dwight9339/microbiome/packs/glade/src/scene.png

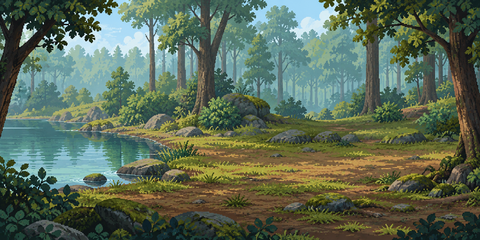
packs/glade/src/scene.png
