dwight9339/microbiome/hardware/enclosure/out/preview_front.png

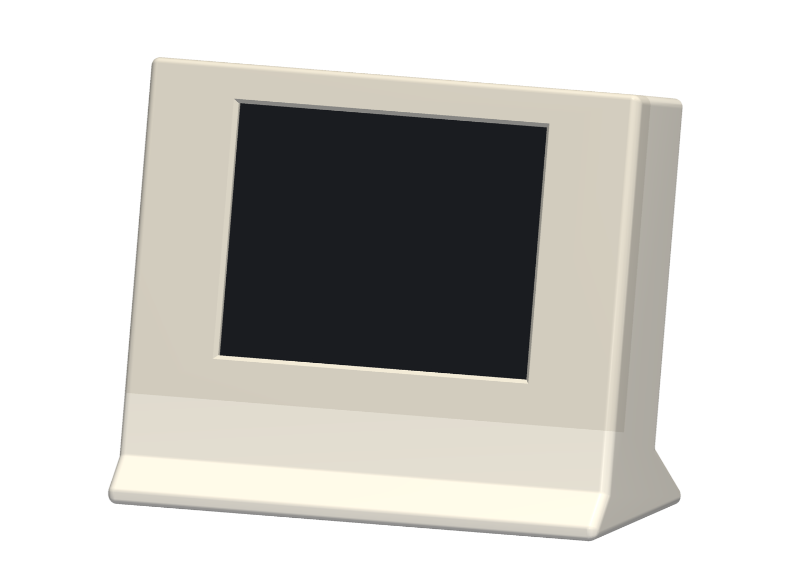
hardware/enclosure/out/preview_front.png
