dwight9339/microbiome/hardware/enclosure/out/preview_rear.png

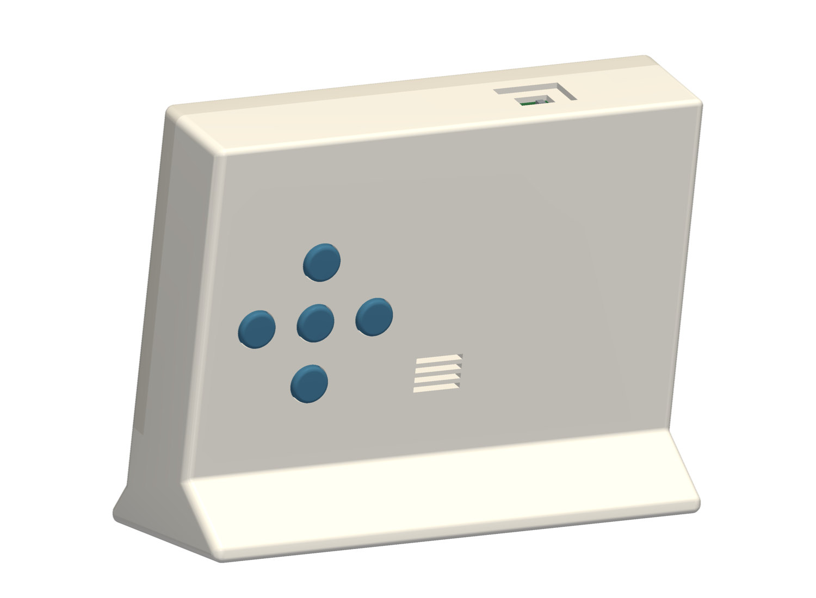
hardware/enclosure/out/preview_rear.png
