dwight9339/microbiome/hardware/enclosure/out/preview_rear_inside.png

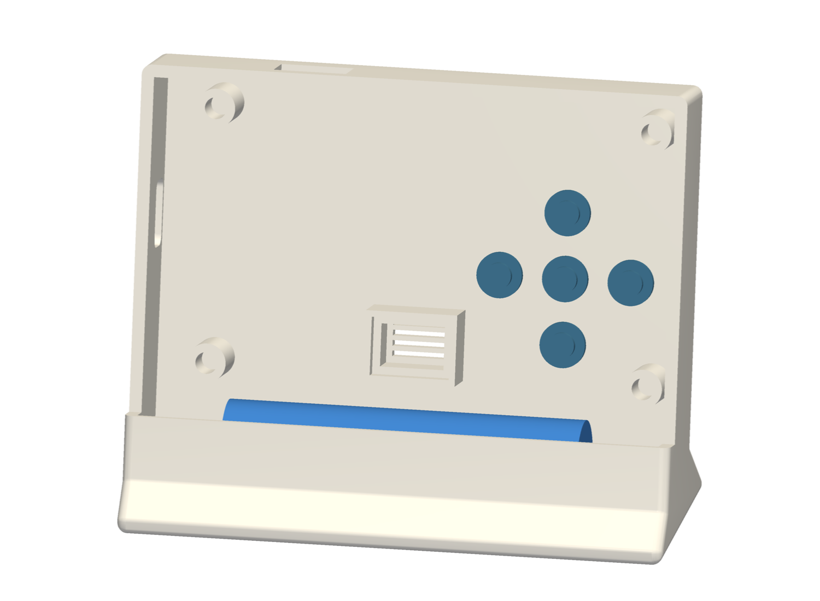
hardware/enclosure/out/preview_rear_inside.png
