dwight9339/microbiome/hardware/enclosure/out/preview_section_buttons.png

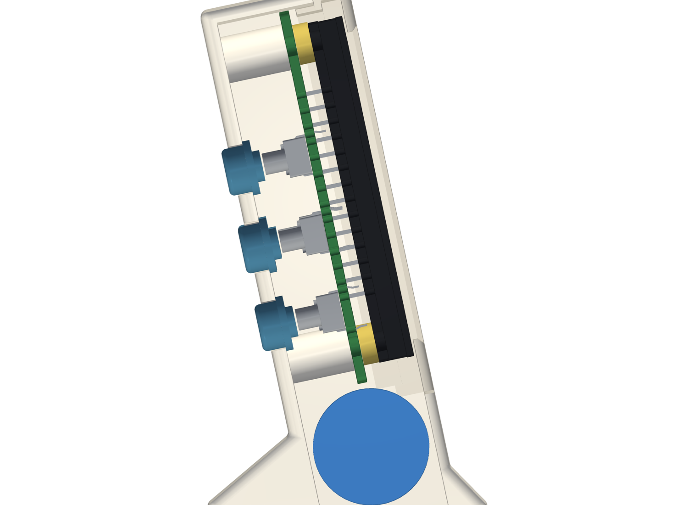
hardware/enclosure/out/preview_section_buttons.png
