dwight9339/microbiome/packs/forest/art/far_trees.png

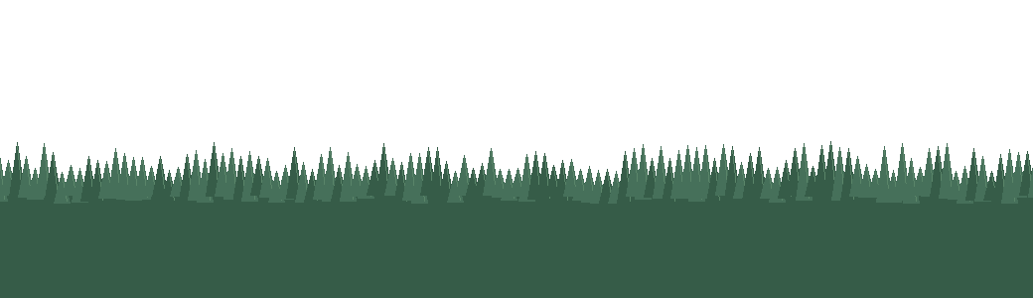
packs/forest/art/far_trees.png
