dwight9339/microbiome/packs/forest/art/foreground.png

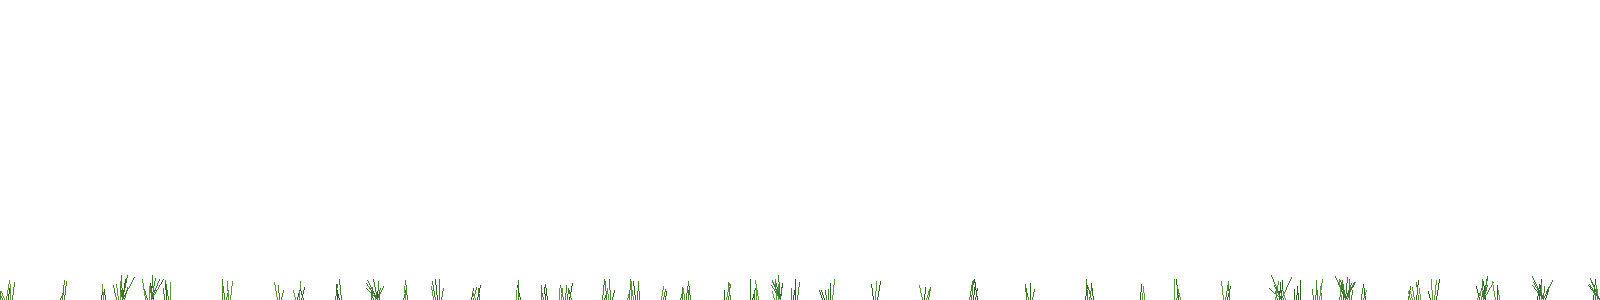
packs/forest/art/foreground.png
