dwight9339/microbiome/packs/forest/art/ground.png

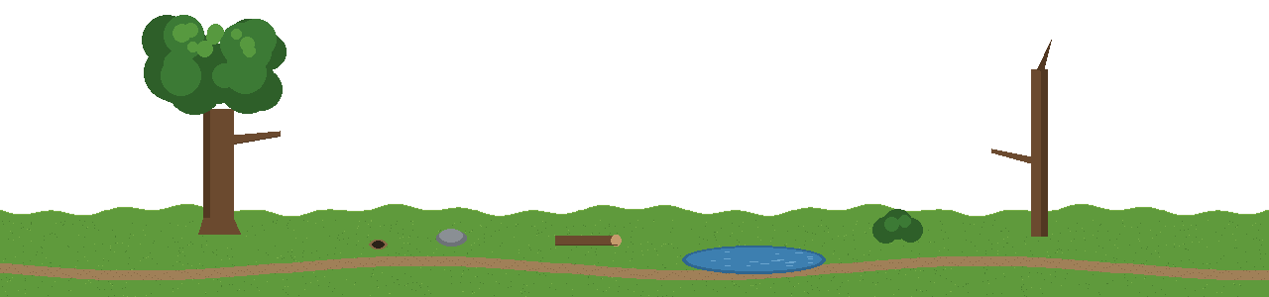
packs/forest/art/ground.png
