dwight9339/microbiome/packs/forest/art/mountains.png

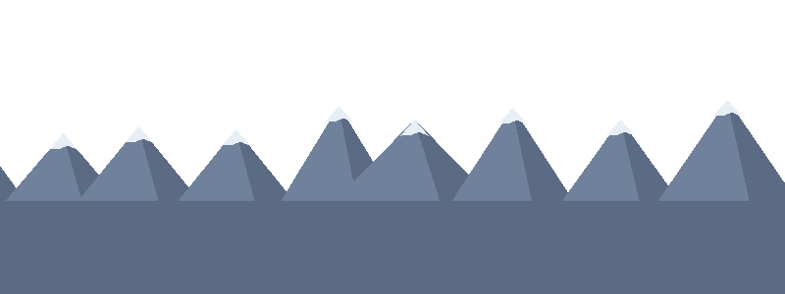
packs/forest/art/mountains.png
