dwight9339/microbiome/packs/glade/art/occlusion.png

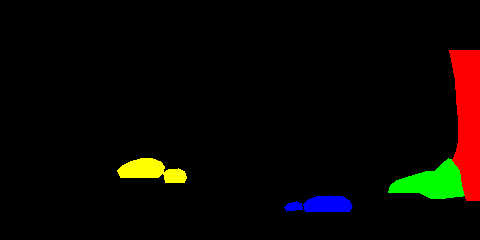
packs/glade/art/occlusion.png
