dwight9339/microbiome/hardware/enclosure/out/microbiome_assembly.FCStd

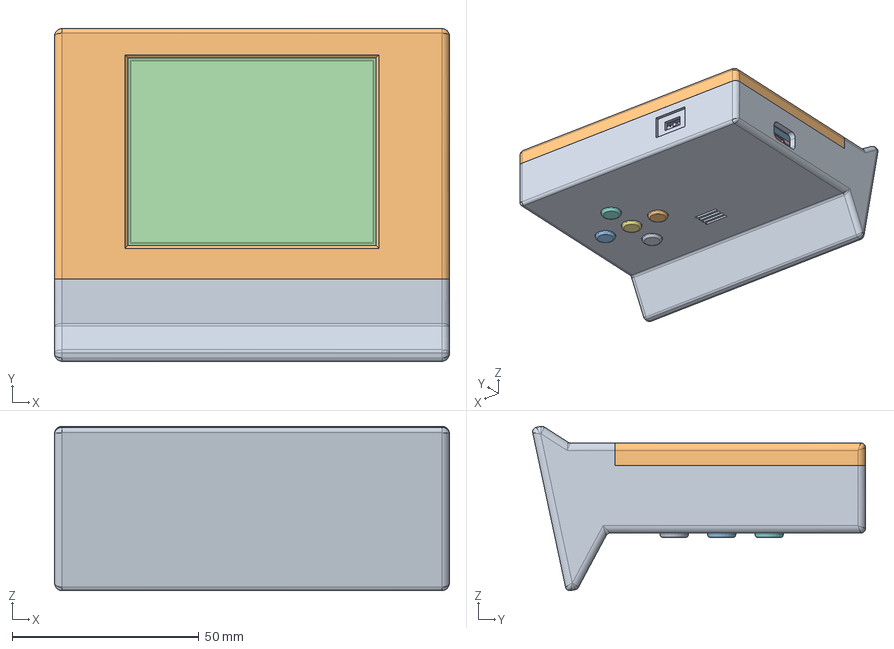
[picture p11: CAD file, 2026-11-13]
hardware/enclosure/out/microbiome_assembly.FCStd
105.7 x 89.1 x 44.0 mm
Rear shell
Front bezel
Carrier PCB
Display module (J2)
Feather RP2350 (J1)
Headers, controls and other components
Button cap - centre
Button cap - up
Button cap - down
Button cap - left
Button cap - right
Display spacer 1
Display spacer 2
Display spacer 3
Display spacer 4
Battery envelope (18.6 x 69 mm)
