dwight9339/microbiome/hardware/prototype_1/prototype_1_pcb.step

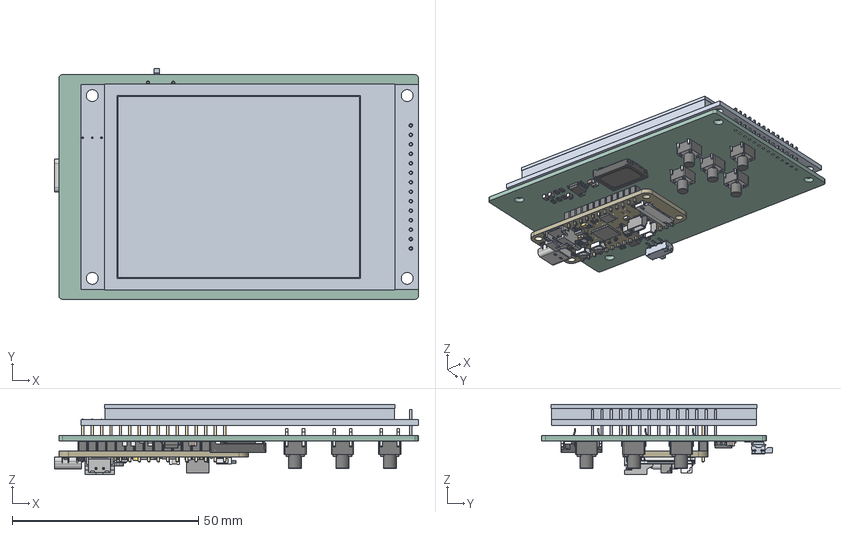
[picture p12: CAD file, 2026-11-13]
hardware/prototype_1/prototype_1_pcb.step
97.7 x 61.9 x 18.9 mm
JS102011SAQN_SW0004_PRT
PinHeader_1x12_P254mm_Vertical
PinHeader_1x16_P254mm_Vertical
Board
0805-NO x 3
CHIPLED_0603_NOOUTLINE x 2
_0402NO x 34
BTN_RKB2_4.6X2.8 x 2
SOT23-5
JSTPH2_BATT
SOT23-5 (1)
0603-NO
SK6805_1515
USON8_4X4
SOD-323F
DFN2015-3
USB_C_CUSB31-CFM2AX-01-X
CRYSTAL_2.5X2
_0603MP x 2
QFN60_7MM_REDUCEDEPAD
INDUCTOR_1007
FPC_22PIN
JST_SH4_RA
JST_SH3_RA
SW_PUSH_6mm_h7.3mm x 5
C_0805_2012Metric x 7
SOIC-8_3.9x4.9mm_P1.27mm x 2
R_0805_2012Metric x 7
AS01508AO-SC-WP-R
prototype_1_PCB
