dwight9339/microbiome/hardware/enclosure/out/rear_shell.step

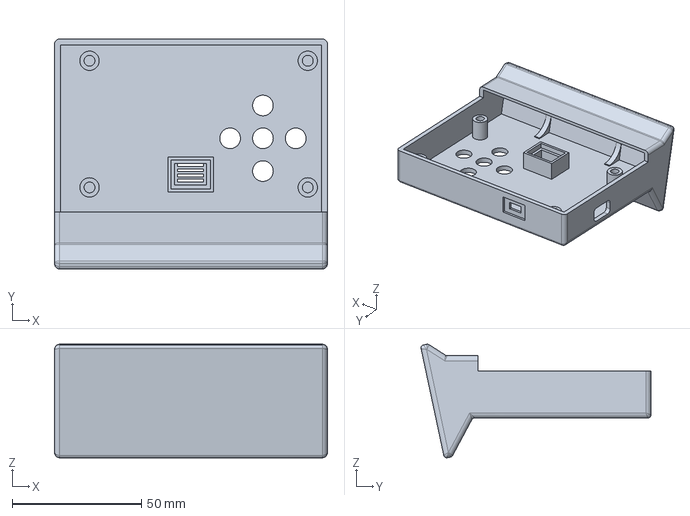
[picture p13: CAD file, 2026-11-13]
hardware/enclosure/out/rear_shell.step
105.7 x 89.1 x 44.0 mm
