dwight9339/microbiome/hardware/prototype_1/3d_models/MSP3223_3p2in_IPS_SPI_DATASHEET_CORRECTED.step

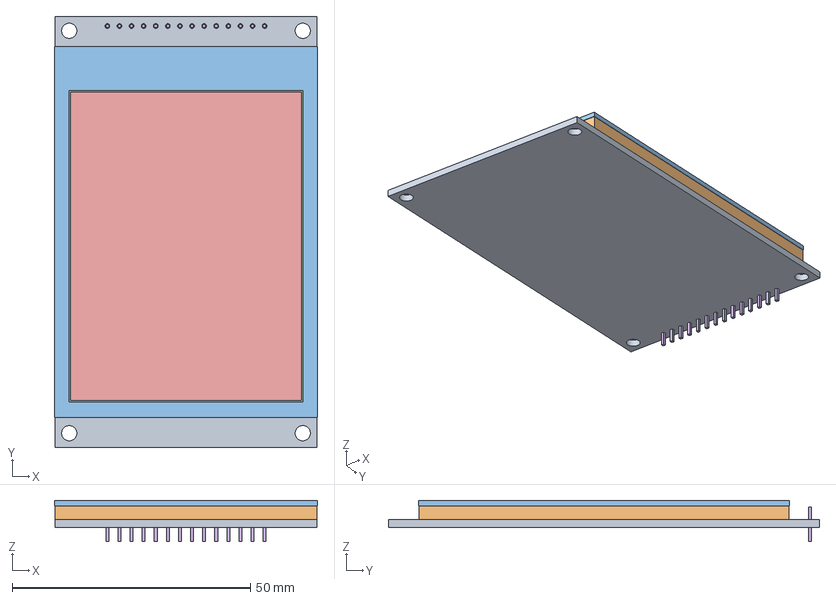
[picture p14: CAD file, 2026-11-13]
hardware/prototype_1/3d_models/MSP3223_3p2in_IPS_SPI_DATASHEET_CORRECTED.step
55.2 x 90.5 x 8.66 mm
