dwight9339/microbiome/hardware/enclosure/out/button_cap.step

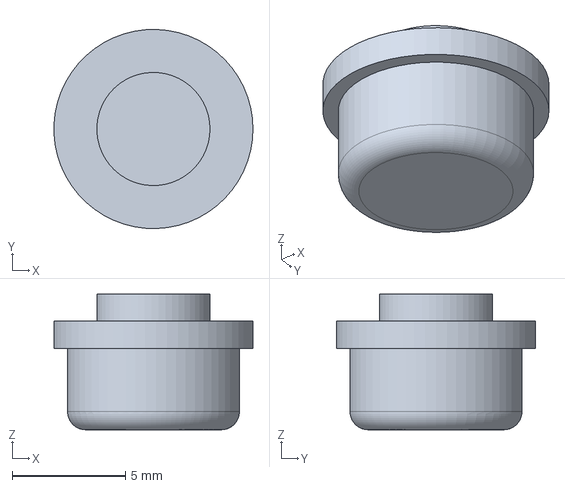
[picture p15: CAD file, 2026-11-13]
hardware/enclosure/out/button_cap.step
8.79 x 8.80 x 5.99 mm
