dwight9339/microbiome/hardware/enclosure/out/display_spacer.step

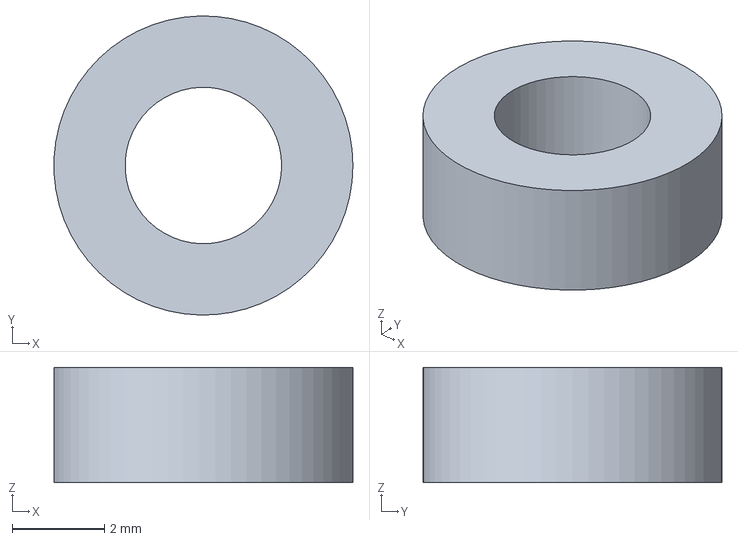
[picture p16: CAD file, 2026-11-13]
hardware/enclosure/out/display_spacer.step
6.50 x 6.50 x 2.50 mm
