dwight9339/microbiome/hardware/enclosure/out/front_bezel.step

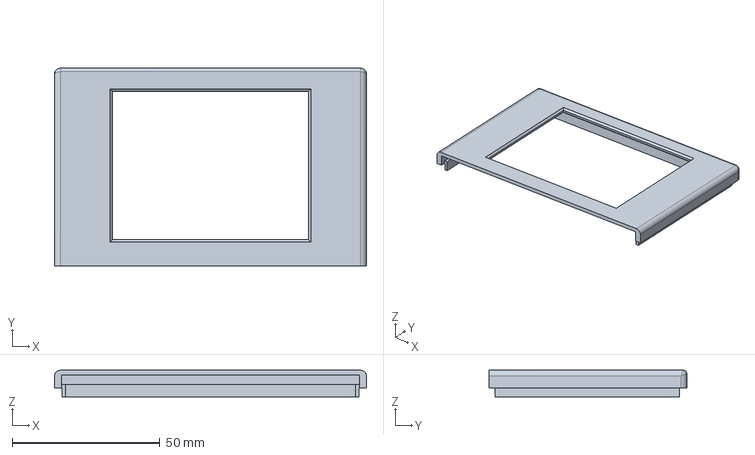
[picture p17: CAD file, 2026-11-13]
hardware/enclosure/out/front_bezel.step
105.7 x 67.0 x 9.00 mm
