dwight9339/microbiome/hardware/prototype_1/3d_models/6000 Feather RP2350.step

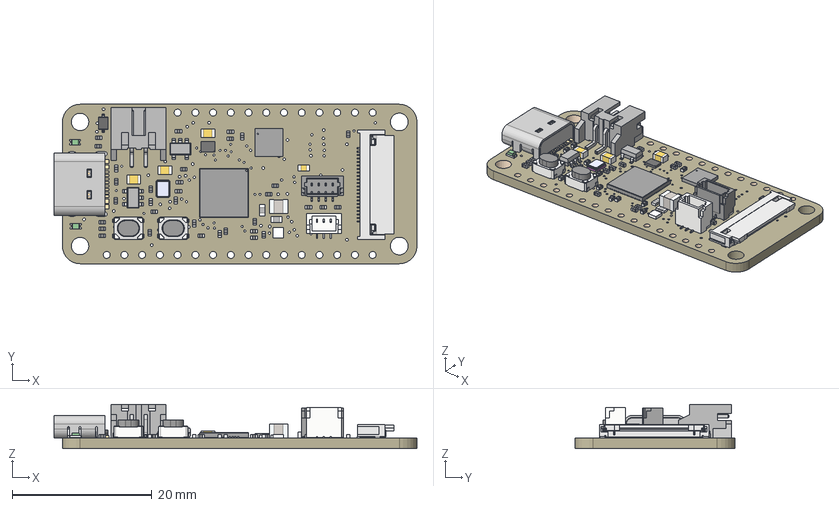
[picture p18: CAD file, 2026-11-13]
hardware/prototype_1/3d_models/6000 Feather RP2350.step
52.0 x 22.9 x 6.37 mm
Board
10uF x 3
ORANGE x 2
10K x 34
KMR2 x 2
RT9080-3.3
JSTPH
MCP73831T-2ACI/OT
10uF_1
WS2812B_SK6805_1515
8MB QSPI
PMEG2020AEA
DMG3415UFY
USB Type C
12MHz/10pF/50ohm
10uF_0603 x 2
DNP
DFE252012F-3R3M=P2
22p TOPCONTACT 0.5mm FPC
STEMMA_I2C_QTRA
JST_SH3
