dwight9339/microbiome/hardware/prototype_1/3d_models/JS102011SAQN.step

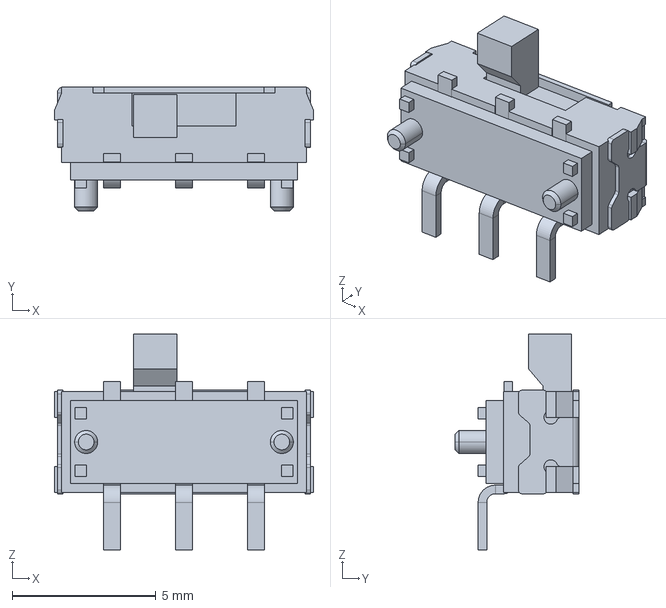
[picture p19: CAD file, 2026-11-13]
hardware/prototype_1/3d_models/JS102011SAQN.step
9.00 x 4.30 x 7.50 mm
