dwight9339/microbiome/hardware/prototype_1/3d_models/AS01508AO-SC-WP-R.STEP

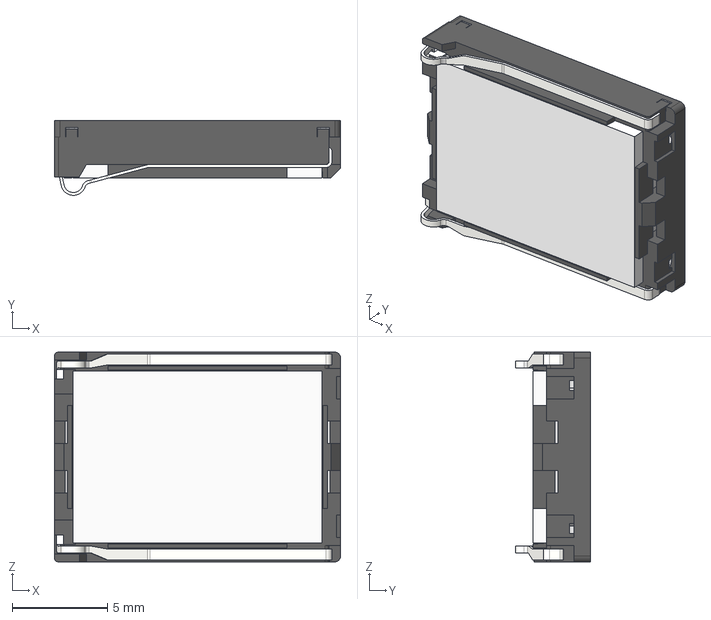
[picture p20: CAD file, 2026-11-13]
hardware/prototype_1/3d_models/AS01508AO-SC-WP-R.STEP
15.0 x 3.92 x 11.0 mm
