dwight9339/microbiome/(list of files, cad)

Other CAD files:
hardware/prototype_1/3d_models/MSP3223_3p2in_IPS_SPI_SIMPLIFIED.step
hardware/enclosure/out/button_cap.stl
hardware/enclosure/out/display_spacer.stl
hardware/enclosure/out/front_bezel.stl
hardware/enclosure/out/rear_shell.stl
