dwight9339/microbiome/hardware/prototype_1/prototype_1.kicad_pcb

## KiCad design hardware/prototype_1/prototype_1.kicad_pcb (2026-11-14)

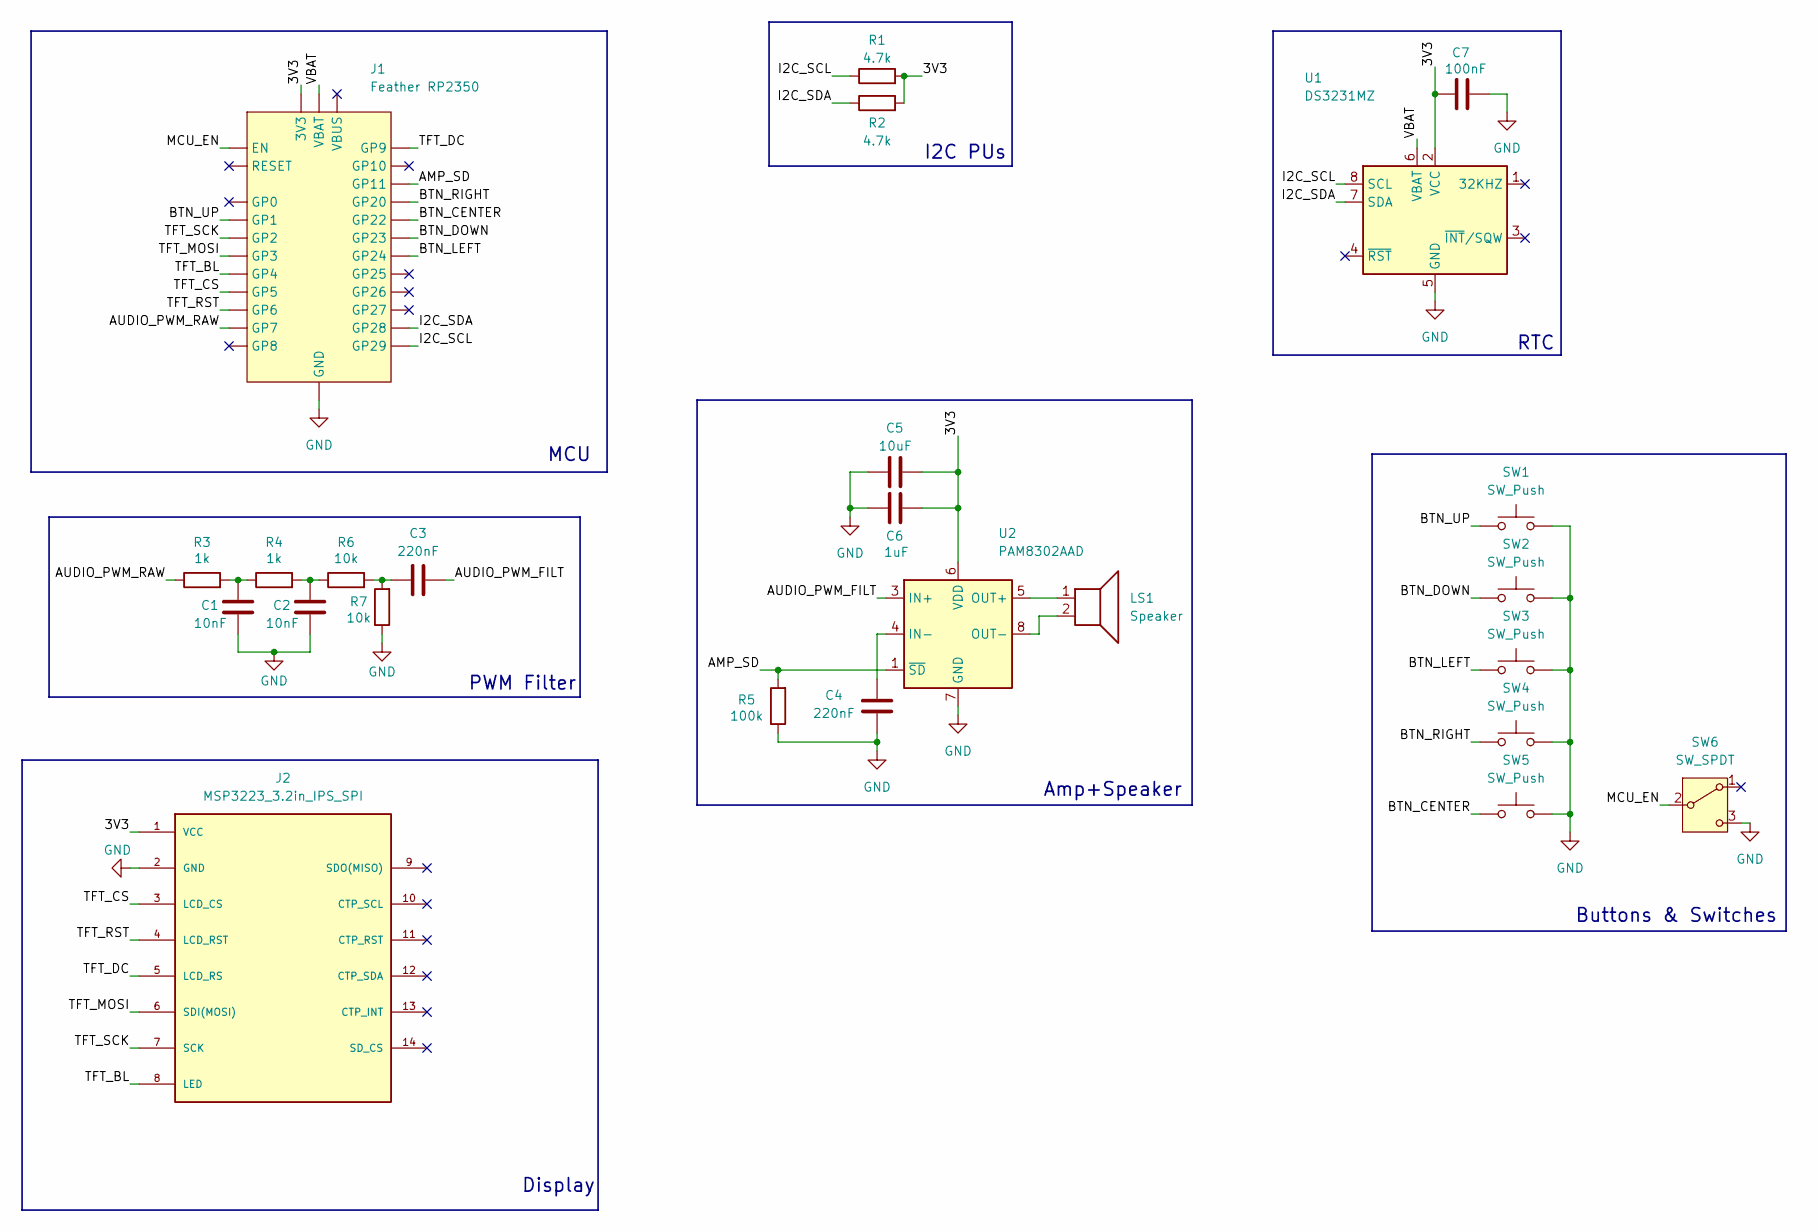
[picture p21: schematic prototype_1.kicad_sch]

Parts:
C1, C2: 10nF; C_0805_2012Metric_Pad1.18x1.45mm_HandSolder
C3, C4: 220nF; C_0805_2012Metric_Pad1.18x1.45mm_HandSolder
C5: 10uF; C_0805_2012Metric_Pad1.18x1.45mm_HandSolder
C6: 1uF; C_0805_2012Metric_Pad1.18x1.45mm_HandSolder
C7: 100nF; C_0805_2012Metric_Pad1.18x1.45mm_HandSolder
J1: Feather RP2350; Adafruit_Feather_RP2350; digikey_part_number 1528-6130-ND
J2: MSP3223_3.2in_IPS_SPI
LS1: Speaker; SPKR_AS01508AO-SC-WP-R; MPN AS01508AO-SC-WP-R; digikey_part_number 668-1514-ND
R1, R2: 4.7k; R_0805_2012Metric_Pad1.20x1.40mm_HandSolder
R3, R4: 1k; R_0805_2012Metric_Pad1.20x1.40mm_HandSolder
R5: 100k; R_0805_2012Metric_Pad1.20x1.40mm_HandSolder
R6, R7: 10k; R_0805_2012Metric_Pad1.20x1.40mm_HandSolder
SW1, SW2, SW3, SW4, SW5: SW_Push; SW_PUSH_6mm_H7.3mm
SW6: SW_SPDT; SW_SPDT_CK_JS102011SAQN
U1: DS3231MZ; SOIC-8_3.9x4.9mm_P1.27mm
U2: PAM8302AAD; SOIC-8_3.9x4.9mm_P1.27mm

Connections:
/3V3: C5.2, C6.2, C7.2, J1.3V3, J2.1 (VCC), R1.2, R2.2, U1.2 (VCC), U2.6 (VDD)
/AMP_SD: J1.GP11, R5.2, U2.1 (~SD)
/AUDIO_PWM_FILT: C3.2, U2.3 (IN+)
/AUDIO_PWM_RAW: J1.GP7, R3.1
/BTN_CENTER: J1.GP22, SW5.1
/BTN_DOWN: J1.GP23, SW2.1
/BTN_LEFT: J1.GP24, SW3.1
/BTN_RIGHT: J1.GP20, SW4.1
/BTN_UP: J1.GP1, SW1.1
/I2C_SCL: J1.GP29, R1.1, U1.8 (SCL)
/I2C_SDA: J1.GP28, R2.1, U1.7 (SDA)
/MCU_EN: J1.EN, SW6.2 (B)
/TFT_BL: J1.GP4, J2.8 (LED)
/TFT_CS: J1.GP5, J2.3 (LCD_CS)
/TFT_DC: J1.GP9, J2.5 (LCD_RS)
/TFT_MOSI: J1.GP3, J2.6 (SDI(MOSI))
/TFT_RST: J1.GP6, J2.4 (LCD_RST)
/TFT_SCK: J1.GP2, J2.7 (SCK)
/VBAT: J1.VBAT, U1.6 (VBAT)
GND: C1.2, C2.2, C4.1, C5.1, C6.1, C7.1, J1.GND, J2.2 (GND), R5.1, R7.1, SW1.2, SW2.2, SW3.2, SW4.2, SW5.2, SW6.3 (C), U1.5 (GND), U2.7 (GND)
unnamed: C1.1, R3.2, R4.1
unnamed: C2.1, R4.2, R6.1
unnamed: C3.1, R6.2, R7.2
unnamed: C4.2, U2.4 (IN-)
unnamed: LS1.1, U2.5 (OUT+)
unnamed: LS1.2, U2.8 (OUT-)

Notes on the sheet:
MCU
Buttons & Switches
Display
I2C PUs
RTC
Amp+Speaker
PWM Filter

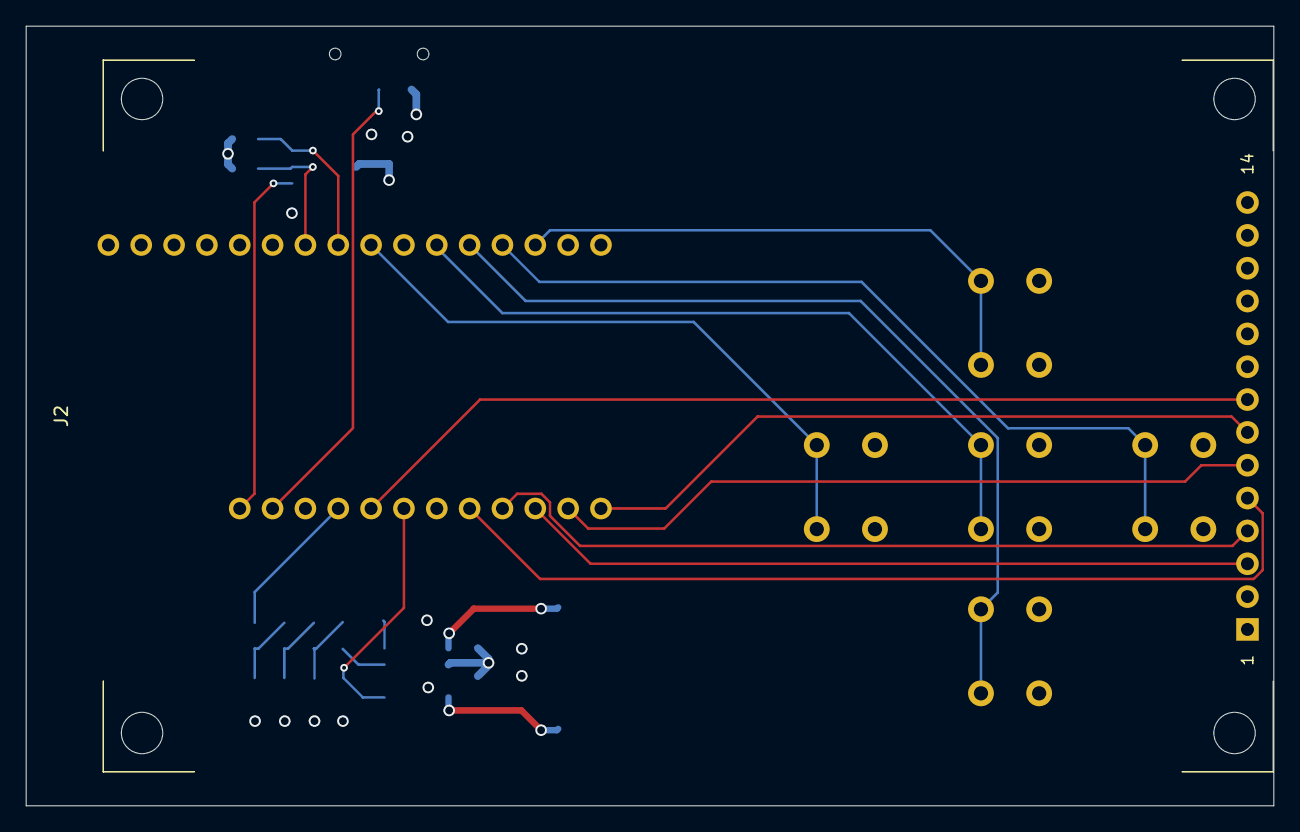
[picture p22: board prototype_1.kicad_pcb from above]

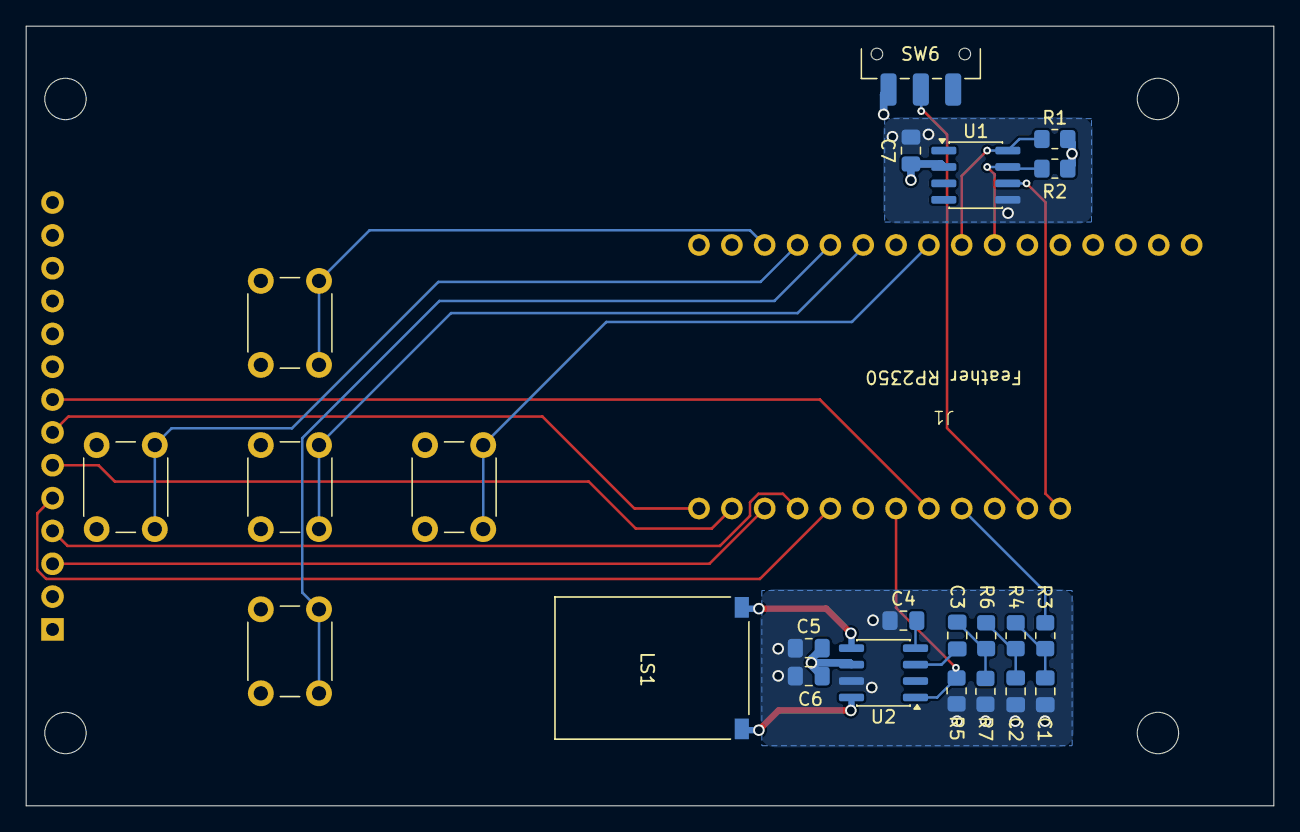
[picture p23: board prototype_1.kicad_pcb from below]

Board: 4 copper layers, 96.5 x 60.3 mm, 25 parts (24 on the bottom side), 26 nets.
