dwight9339/microbiome/(commit log)

2026-11-01 Scaffold data-driven ambient ecosystem engine
    - core/: portable C11 engine (no heap): pack loader/validator, clock and
    world variables (step/markov/sensor), conditions, spawning, weighted
    state-machine actors with tag-based reactions and place affordances,
    particles, palette-based time-of-day lighting, strip renderer with
    integer scaling and auto parallax
    - tools/packc: YAML + PNG -> binary pack compiler with --watch
    - packs/forest: first pack with placeholder art (tools/placeholder_art.py)
    - platform/sdl: desktop simulator with hot reload and debug controls
    - platform/headless: mbsnap PNG renderer, used by ctest smoke tests
    - platform/rp2350: Pico 2 firmware (ST7789 DMA strips, butt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
2026-11-02 Windows support for desktop tools, CI, per-OS setup docs
    - mbsim: define SDL_MAIN_HANDLED so it links on Windows without SDL2main
    (previously failed with "undefined reference to WinMain"); copy SDL2.dll
    next to mbsim.exe; --exit-after for headless smoke runs; fail cleanly if
    SDL setup fails
    - CMake: MB_REQUIRE_SDL option, _CRT_SECURE_NO_WARNINGS on MSVC,
    simulator_smoke test (2 s run with SDL_VIDEODRIVER=dummy)
    - CI: desktop build+tests on Ubuntu and Windows (MSVC + official SDL2 VC
    package), ASan/UBSan soak on Ubuntu, RP2350 firmware builds (with and
    without RTC) uploaded as artifacts
    - README: Ubuntu (apt packages; pip is blocked on 23.04+), macOS, Windows
    (VS 2022 / vcpkg /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
    [main.c]
2026-11-02 Route walkers around obstacles so animals stop crossing the pond
    Movement was a straight line to a target anywhere in the lane, so ground
    animals wandered into, cut across and exited through the pond (~7% of
    ground-actor frames in a 15-game-day soak).
    - Pack format v2: an `obstacles` section of per-lane ellipses; the forest
    pack declares the pond with the same box the art draws it in.
    - Walkers plan over a small visibility graph (start, target, padded box
    corners), follow the first leg and replan at each corner. Paths keep
    1 px clear of the shore; targets and starts that land inside are pushed
    out to the edge (drinking spots' spread reaches into the water).
    - Wander targets and "any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
2026-11-03 rp2350: make -DLCD_SPI_HZ actually reach the firmware
    The docs and bench checklist say to pass -DLCD_SPI_HZ=75000000 to cmake,
    but nothing forwarded the cache variable to the compiler, so it silently
    built the default 37.5 MHz image. Forward it as a compile definition when
    set. Also ignore pico-sdk/, which the README has you clone into the repo.
2026-11-03 wasm: address review (HTML injection, JSON overflow, Node 18)
    - Viewer: pack-sourced names (actors, states, spawn rules) were put into
    the page through innerHTML, so a crafted .mbp could run script. Build
    those nodes with textContent instead. A smoke check fails if
    index.html uses any HTML-parsing sink.
    - JSON: the host wrote JSON into a fixed 64 KiB buffer and, on
    overflow, returned an error object that Engine.load() accepted as
    pack info. The JSON area now lives above the framebuffer and doubles
    until the document fits; the export returns 0 only if memory can't
    grow, which the wrapper turns into a MicrobiomeError, unloading the
    engine so `loaded` stays consistent.
    - Node 18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
2026-11-05 wasm: fix review findings (camera drift, labels, JSON, viewer)
    - Add mb_engine_warmup(): the init-time warm-up (simulate only, camera
    and idle timer untouched). The JS wrapper and mbsnap used update loops
    instead, so idle time built up during warm-up and the camera started
    drifting as soon as a pack loaded. Both now call it (mbw_warmup /
    Engine.warmup), and parity mirrors mbsnap with it.
    - packc caps enum labels at 255 bytes and the hosts use 256-byte buffers,
    so labels are never silently cut off (pin() picked the wrong value).
    - JSON: keep the area size that last fit instead of regrowing from 64 KiB
    every call; count written actors for commas so a skipped entry can't
    produce i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
    [main.c]
2026-11-05 docs: draft gift-first vision and coordinated three-track roadmaps
2026-11-05 docs: target Christmas gift at Feather RP2350 carrier and battery-powered TFT
2026-11-05 docs: plan the gift for one person and cut Studio to a basic version
    - gift-2026.md is now the only file with dates; the roadmap, tracks and
    hardware plan link to it instead of repeating the gates.
    - Reorder the six weeks so the waiting work (PCB order, parts, prints)
    starts first and software fills the fabrication time.
    - Studio for the gift becomes a local dev server plus the Wasm viewer:
    live rebuild/reload, error banner, drag-to-move places/lanes/obstacles
    and comment-preserving save. Tauri, editor forms and PNG import move
    after Christmas, with YAML + packc --watch + mbsim as the fallback.
    - The bird/rabbit slice is a should everywhere; the definition of done
    no longer lists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
2026-11-12 Add ILI9341 support and a board file for the 3.2" MSP3223 display
    - board_config.h: every setting is now overridable, and -DMB_BOARD_CONFIG=<file>
    (previously documented but never wired up) includes a board header first.
    - LCD driver: LCD_CONTROLLER selects ST7789 (default) or ILI9341; the ILI9341
    path sends LCDwiki's power/VCOM/gamma init for the MSP3222/MSP3223 IPS panel.
    - Compile-time check that LCD_PIN_SCK/LCD_PIN_MOSI are real SPI SCK/TX pins on
    the same SPI block, since a clock on any other pin fails silently.
    - boards/ili9341_32.h: breadboard Pico 2 + MSP3223 wiring and orientation.
    - Serial console: "fill RRGGBB" holds a solid colour, "run" resumes, for
    display bring-up.
    - C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
    [board_config.h, ili9341_32.h, main.c, st7789.c]
2026-11-12 Add the Glade pack and let walkers route round lane-edge obstacles
    Glade puts the forest animals in a painted 480x240 lakeside clearing.
    prepare_art.py reduces the painting (src/scene.png) to 200 colours and
    splits the open sky into its own layer so stars and particles sit behind
    the canopy. The sprites are still the forest placeholders. It builds
    alongside forest (glade.mbp, glade_loads test) and on firmware with
    -DMB_PACK=glade.
    The lake runs up to the far edge of the walkers' lane, so the route
    planner dropped both of its far corners as out of lane and animals had
    no way round. Corners outside the lane are now clamped into it instead
    of skipped; they stay beside the box, so still clear o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
    [pack.yaml]
2026-11-13 Add the prototype 1 KiCad project under hardware/
    Moves the first prototype carrier board (Feather RP2350, MSP3223 3.2"
    display, DS3231 RTC, PAM8302 amp and speaker, buttons) into the repo
    from a local CAD folder: schematic, board, project-local symbol and
    footprint libraries, component 3D models, BOM export and the board
    STEP export for enclosure work.
    hardware/.gitignore keeps KiCad's local state, backups and lock files
    out of git.
    Claude-Session: https://claude.ai/code/session_01CjTZcdrtZHTWub5xoj69NM
    [6000 Feather RP2350.step, AS01508AO-SC-WP-R.STEP, JS102011SAQN.step, MSP3223_3p2in_IPS_SPI_DATASHEET_CORRECTED.step, MSP3223_3p2in_IPS_SPI_SIMPLIFIED.step, prototype_1.csv, prototype_1.kicad_pcb, prototype_1.kicad_sch]
2026-11-13 Make the prototype 1 KiCad project self-contained
    The Feather RP2350 symbol and footprint and the speaker footprint came
    from libraries outside the repo. Copy them into the project libraries
    and point the schematic, board and BOM export at the project copies:
    - microbiome_prototype_1.kicad_sym: Adafruit_Feather_RP2350 symbol
    (new library, registered in sym-lib-table)
    - footprints.pretty: Adafruit_Feather_RP2350 and
    SPKR_AS01508AO-SC-WP-R footprints
    Also fix the MSP3223 symbol's default footprint, which still named a
    library outside the project.
    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
    [prototype_1.csv, prototype_1.kicad_pcb, prototype_1.kicad_sch]
2026-11-13 Make the camera autopilot hold a view and glide rarely and slowly
    The idle autopilot used to chase a randomly chosen animal at up to half
    the manual pan speed (70 px/s in Glade), re-pick every 20-45 s or as soon
    as its subject started leaving, and sweep end to end when the scene was
    empty. It drew the eye and tracked back and forth.
    Now it holds a framing and only glides to a clearly better one:
    - candidate framings are a quarter view apart, at most one view away;
    - resting animals score 3, moving ones 1, leaving/fleeing ones 0, and a
    glide needs best >= current + 2 and >= 1.5x current;
    - after a glide it holds for at least 3 minutes and won't reverse
    direction within 8; an empty scene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
    [pack.yaml]
2026-11-13 Update prototype PCB layout and add enclosure assembly
    [button_cap.step, button_cap.stl, display_spacer.step, display_spacer.stl, front_bezel.step, front_bezel.stl, microbiome_assembly.FCStd, prototype_1.kicad_pcb]
2026-11-14 Let actors pass behind scenery: per-pixel occluders
    The Glade painting has objects in the middle of the clearing (the
    right-hand trunk, the rocks at its base, a mossy rock, the shore rocks)
    that animals should be able to walk behind as well as in front of.
    An occluder is a cropped 0/1 mask plus the y where the object meets the
    ground. When an actor's feet are above that base, its pixels under the
    mask aren't drawn and the painting shows through; feet on or below it are
    in front. It uses the same feet-y depth that orders actors among
    themselves, and can be limited to certain lanes so birds flying past a
    trunk stay visible. Rows with no occluder in front of an actor keep the
    old drawing loop.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
2026-11-14 Change pin assignments for I2C, audio PWM, and amp SD
    [prototype_1.kicad_pcb, prototype_1.kicad_sch]
2026-11-14 Route prototype 1 PCB, add planes and pours, export gerbers
    Route the board and add a GND plane on In1.Cu and a 3V3 plane on In2.Cu,
    plus local GND pours on B.Cu around the audio section and the RTC, with
    stitching vias tying each pour island to the GND plane. Zones use thermal
    reliefs on through-hole pins and solid connections on SMD pads. GND joins
    3V3 in the PWR net class.
    Add fab outputs: 4-layer gerbers, separate PTH/NPTH Excellon drill files
    with drill maps, the gerber job file, and a zip of all of them.
    [prototype_1-B_Cu.gbl, prototype_1-B_Mask.gbs, prototype_1-B_Paste.gbp, prototype_1-B_Silkscreen.gbo, prototype_1-Edge_Cuts.gm1, prototype_1-F_Cu.gtl, prototype_1-F_Mask.gts, prototype_1-F_Paste.gtp]
